Pollex/PZLD-Zoutwachter/hardware/Pinout v0.3.png

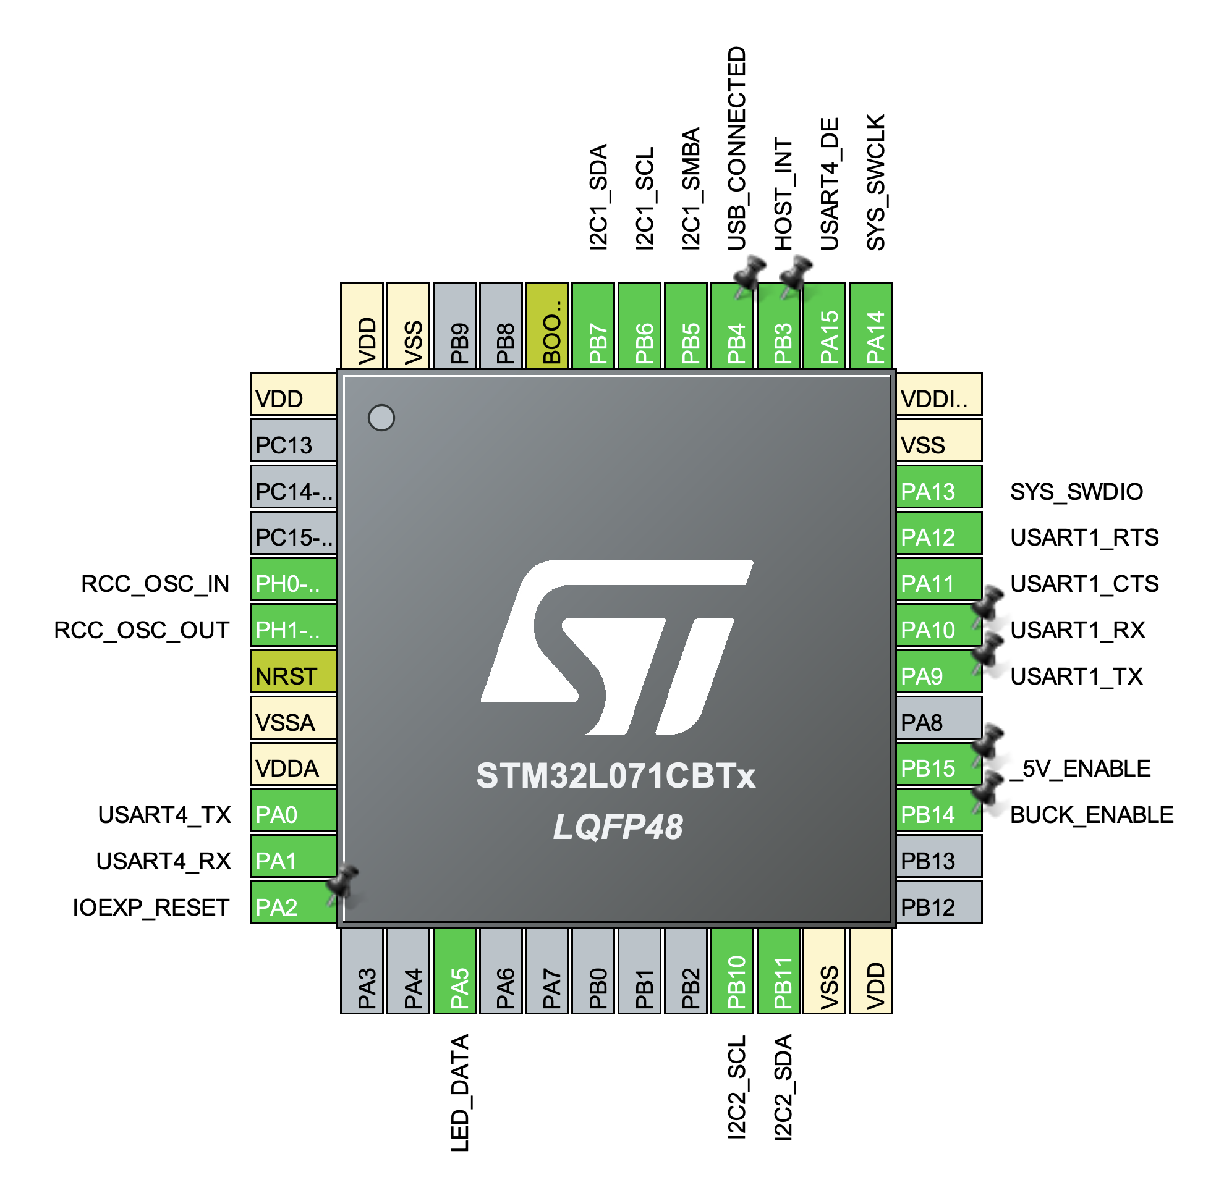
hardware/Pinout v0.3.png
