Pollex/PZLD-Zoutwachter/hardware/MCU.kicad_sch

## KiCad design hardware/MCU.kicad_sch (2025-06-18)

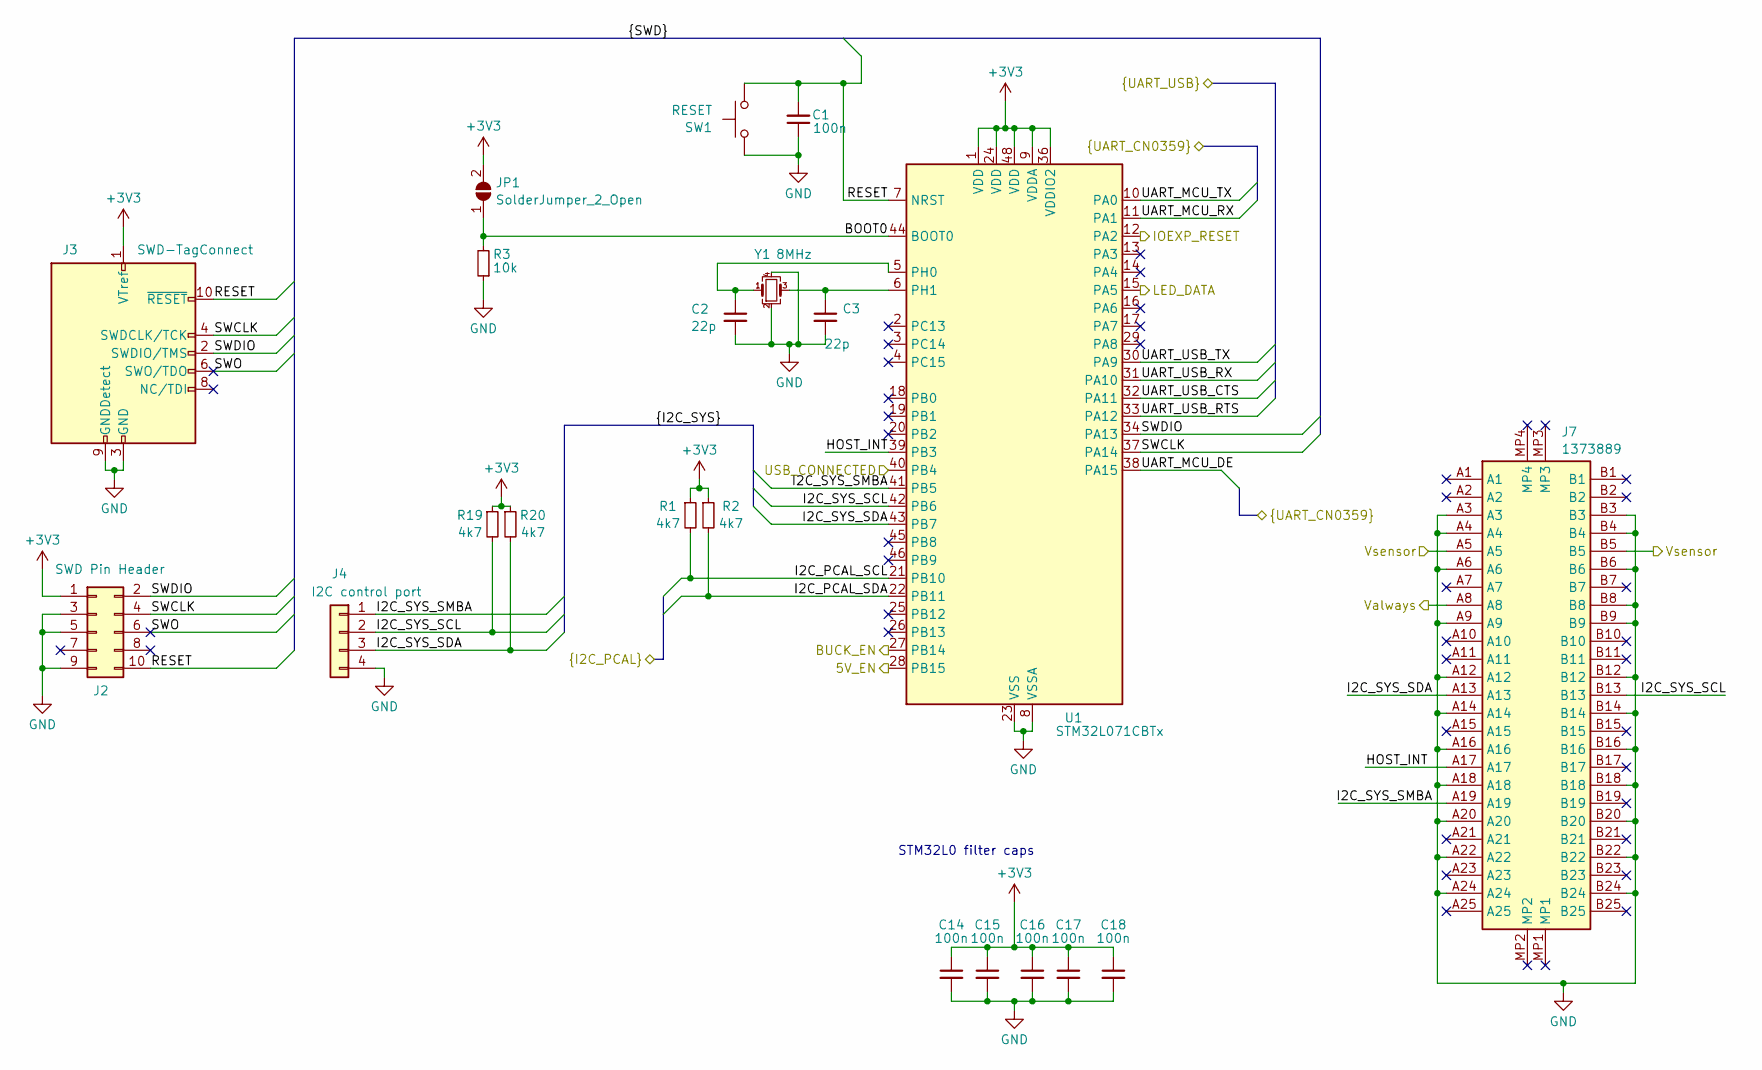
[picture p3: schematic MCU.kicad_sch]

Parts:
C1, C14, C15, C16, C17, C18: 100n; C_0603_1608Metric; LCSC MFR YAGEO
C2, C3: 22p; C_0603_1608Metric; LCSC MFR Samsung Electro-Mechanics
J2: SWD Pin Header; PinHeader_2x05_P1.27mm_Vertical_SMD; LCSC MFR Shenzhen Kinghelm Elec
J3: SWD-TagConnect; Tag-Connect_TC2050-IDC-NL_2x05_P1.27mm_Vertical_with_bottom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
J4: I2C control port; DEALON DW254S-22-04-85 SMD 2x2pin 2.54mm straight; LCSC MFR DEALON
J7: 1373889; Manufacturer_Part_Number 1373889; LCSC MFR Phoenix Contact
JP1: SolderJumper_2_Open; SolderJumper-2_P1.3mm_Open_RoundedPad1.0x1.5mm
R1, R2, R19, R20: 4k7; R_0603_1608Metric; LCSC MFR UNI-ROYAL(Uniroyal Elec)
R3: 10k; R_0603_1608Metric; LCSC MFR UNI-ROYAL(Uniroyal Elec)
SW1: RESET; SW_Push_1P1T_XKB_TS-1187A; LCSC MFR XKB Connectivity
U1: STM32L071CBTx; LQFP-48_7x7mm_P0.5mm; LCSC MFR STMicroelectronics
Y1: 8MHz; Crystal_SMD_3225-4Pin_3.2x2.5mm; LCSC MFR ECS INTERNATIONAL INC

Connections:
5V_EN: U1.28 (PB15)
+3V3: C14.1, C15.1, C16.1, C17.1, C18.1, J2.1, J3.1 (VTref), JP1.2 (B), R1.1, R2.1, R19.1, R20.1, U1.1 (VDD), U1.9 (VDDA), U1.24 (VDD), U1.36 (VDDIO2), U1.48 (VDD)
BOOT0: JP1.1 (A), R3.2, U1.44 (BOOT0)
BUCK_EN: U1.27 (PB14)
GND: C1.1, C2.2, C3.2, C14.2, C15.2, C16.2, C17.2, C18.2, J2.3, J2.5, J2.9, J3.3 (GND), J3.5 (GND), J3.9 (GNDDetect), J4.4, J7.A3, J7.A4, J7.A6, J7.A9, J7.A12, J7.A14, J7.A16, J7.A18, J7.A20, J7.A22, J7.A24, J7.B3, J7.B4, J7.B6, J7.B8, J7.B9, J7.B12, J7.B14, J7.B16, J7.B18, J7.B20, J7.B22, J7.B24, R3.1, SW1.1, U1.8 (VSSA), U1.23 (VSS), U1.35 (VSS), U1.47 (VSS), Y1.2, Y1.4
HOST_INT: J7.A17, U1.39 (PB3)
I2C_PCAL_SCL: R1.2, U1.21 (PB10)
I2C_PCAL_SDA: R2.2, U1.22 (PB11)
I2C_SYS_SCL: J4.2, J7.B13, R19.2, U1.42 (PB6)
I2C_SYS_SDA: J4.3, J7.A13, R20.2, U1.43 (PB7)
I2C_SYS_SMBA: J4.1, J7.A19, U1.41 (PB5)
IOEXP_RESET: U1.12 (PA2)
LED_DATA: U1.15 (PA5)
unnamed: C2.1, U1.5 (PH0), Y1.1
unnamed: C3.1, U1.6 (PH1), Y1.3
RESET: C1.2, J2.10, J3.10 (~RESET), SW1.2, U1.7 (NRST)
SWCLK: J2.4, J3.4 (SWDCLK/TCK), U1.37 (PA14)
SWDIO: J2.2, J3.2 (SWDIO/TMS), U1.34 (PA13)
SWO: J2.6, J3.6 (SWO/TDO)
UART_MCU_DE: U1.38 (PA15)
UART_MCU_RX: U1.11 (PA1)
UART_MCU_TX: U1.10 (PA0)
UART_USB_CTS: U1.32 (PA11)
UART_USB_RTS: U1.33 (PA12)
UART_USB_RX: U1.31 (PA10)
UART_USB_TX: U1.30 (PA9)
USB_CONNECTED: U1.40 (PB4)
Valways: J7.A8
Vsensor: J7.A5, J7.B5

Notes on the sheet:
STM32L0 filter caps
