Pollex/PZLD-Zoutwachter/hardware/Mechanical.kicad_sch

## KiCad design hardware/Mechanical.kicad_sch (2025-06-18)

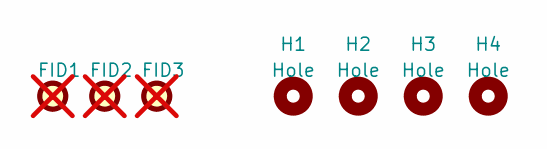
[picture p4: schematic Mechanical.kicad_sch]

Parts:
FID1, FID2, FID3: Fiducial; Fiducial_1mm_Mask2mm; not fitted
H1, H2, H3, H4: Hole; MountingHole_3.2mm_M3
