Pollex/PZLD-Zoutwachter/hardware/Power.kicad_sch

## KiCad design hardware/Power.kicad_sch (2025-06-18)

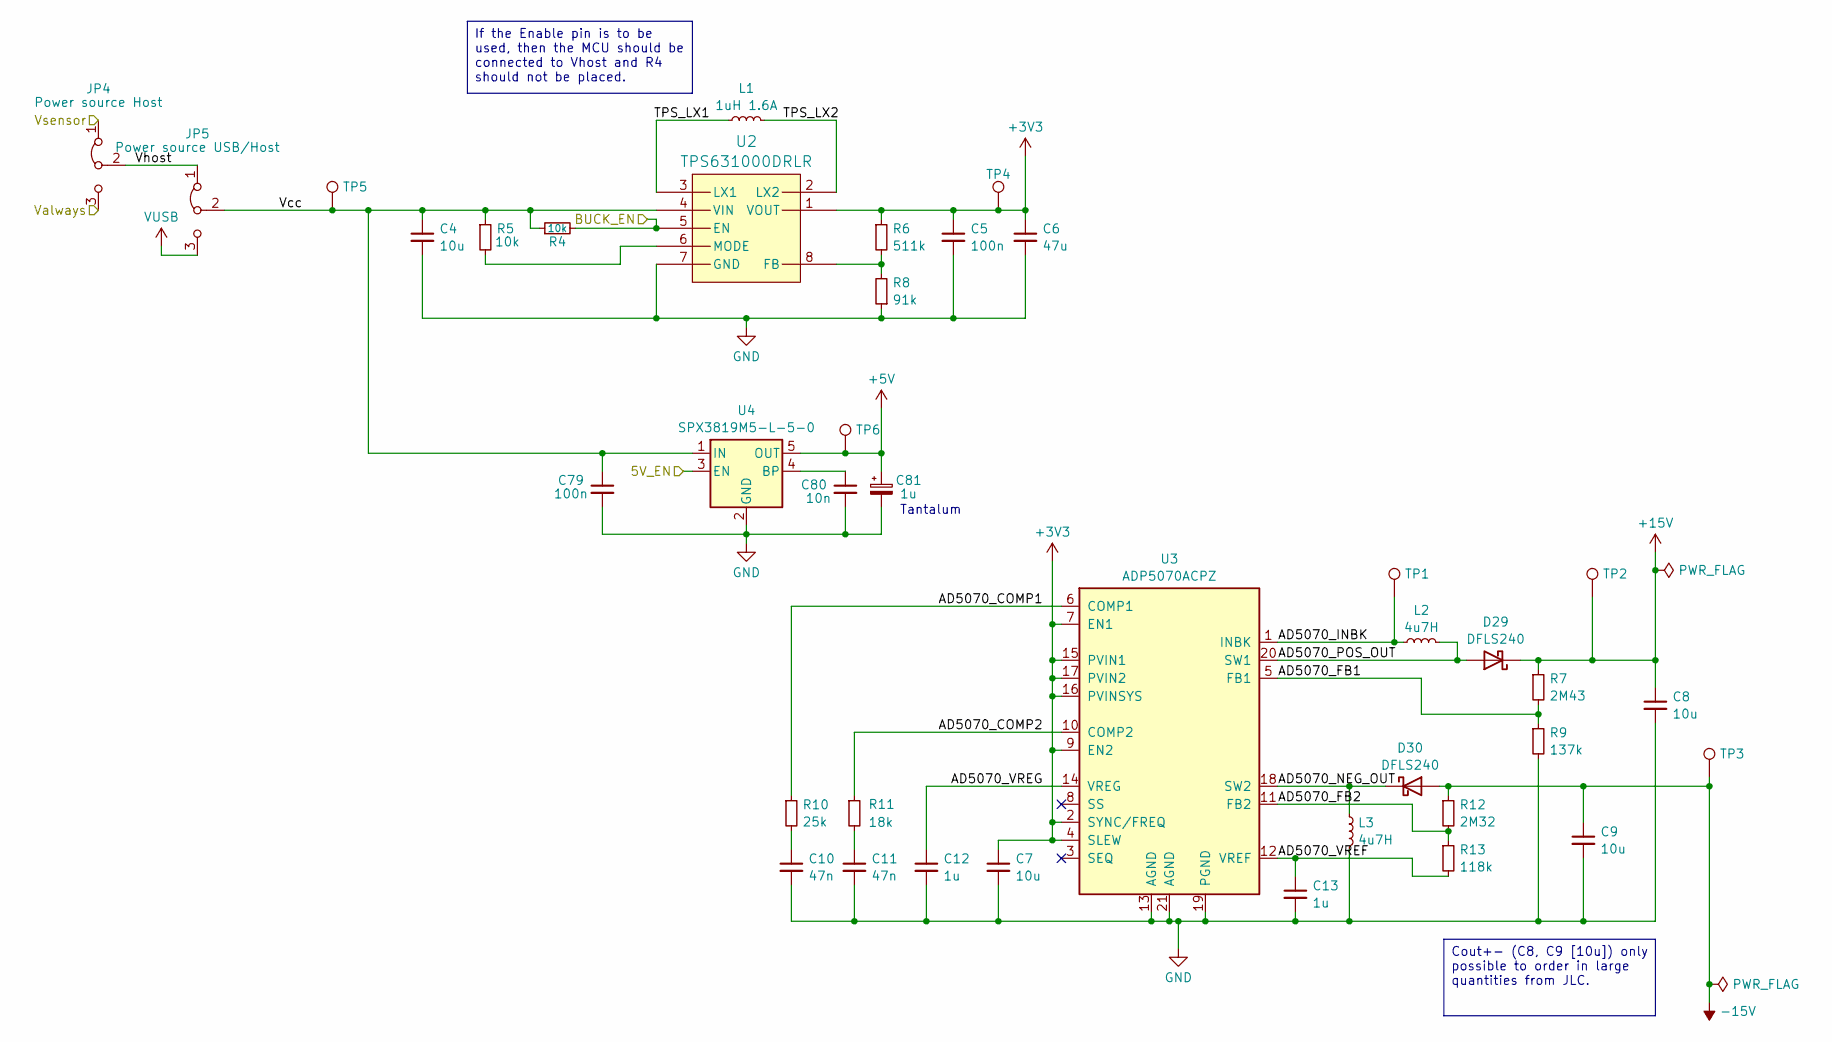
[picture p5: schematic Power.kicad_sch]

Parts:
C4, C7: 10u; C_1206_3216Metric; LCSC MFR Taiyo Yuden
C5, C79: 100n; C_0603_1608Metric; LCSC MFR YAGEO
C6: 47u; C_0603_1608Metric; LCSC MFR Samsung Electro-Mechanics
C8, C9: 10u; C_1210_3225Metric; LCSC MFR Murata Electronics
C10, C11: 47n; C_0603_1608Metric; LCSC MFR Murata Electronics
C12, C13: 1u; C_0603_1608Metric; LCSC MFR Murata Electronics
C80: 10n; C_0603_1608Metric; LCSC MFR FH (Guangdong Fenghua Advanced Tech)
C81: 1u; CP-3216-18; LCSC MFR Vishay Intertech
D29, D30: DFLS240; D_PowerDI-123; LCSC MFR Diodes Inc.
JP4: Power source Host; PinHeader_1x03_P2.54mm_Vertical
JP5: Power source USB/Host; PinHeader_1x03_P2.54mm_Vertical
L1: 1uH 1.6A; L_0603_1608Metric; LCSC MFR Murata Electronics
L2, L3: 4u7H; L_Wuerth_MAPI-4030; LCSC MFR WURTH ELEKTRONIK
R4, R5: 10k; R_0603_1608Metric; LCSC MFR UNI-ROYAL(Uniroyal Elec)
R6: 511k; R_0603_1608Metric; LCSC MFR YAGEO
R7: 2M43; R_0805_2012Metric; LCSC MFR YAGEO
R8: 91k; R_0603_1608Metric; LCSC MFR YAGEO
R9: 137k; R_0603_1608Metric; LCSC MFR YAGEO
R10: 25k; R_0603_1608Metric; LCSC MFR Viking Tech
R11: 18k; R_0603_1608Metric; LCSC MFR UNI-ROYAL(Uniroyal Elec)
R12: 2M32; R_0603_1608Metric; LCSC MFR YAGEO
R13: 118k; R_0603_1608Metric; LCSC MFR YAGEO
TP1, TP2, TP3, TP4, TP5, TP6: TestPoint_Pad_D1.5mm
U2: TPS631000DRLR; TPS631000DRLR_TEX; LCSC MFR TEXAS INSTRUMENTS
U3: ADP5070ACPZ; LFCSP-20-1EP_4x4mm_P0.5mm_EP2.6x2.6mm; LCSC Part # C659268
U4: SPX3819M5-L-5-0; SOT-23-5; LCSC MFR MaxLinear

Connections:
5V_EN: U4.3 (EN)
+3V3: C5.1, C6.1, C7.1, R6.1, TP4.1, U2.1 (VOUT), U3.2 (SYNC/FREQ), U3.4 (SLEW), U3.7 (EN1), U3.9 (EN2), U3.15 (PVIN1), U3.16 (PVINSYS), U3.17 (PVIN2)
+5V: C81.1, TP6.1, U4.5 (OUT)
+15V: C8.1, D29.1 (K), R7.1, TP2.1
-15V: C9.1, D30.2 (A), R12.1, TP3.1
AD5070_COMP1: R10.1, U3.6 (COMP1)
AD5070_COMP2: R11.1, U3.10 (COMP2)
AD5070_FB1: R7.2, R9.1, U3.5 (FB1)
AD5070_FB2: R12.2, R13.1, U3.11 (FB2)
AD5070_INBK: L2.1, TP1.1, U3.1 (INBK)
AD5070_NEG_OUT: D30.1 (K), L3.1, U3.18 (SW2)
AD5070_POS_OUT: D29.2 (A), L2.2, U3.20 (SW1)
AD5070_VREF: C13.1, R13.2, U3.12 (VREF)
AD5070_VREG: C12.1, U3.14 (VREG)
BUCK_EN: R4.2, U2.5 (EN)
GND: C4.2, C5.2, C6.2, C7.2, C8.2, C9.2, C10.2, C11.2, C12.2, C13.2, C79.2, C80.2, C81.2, L3.2, R8.1, R9.2, U2.7 (GND), U3.13 (AGND), U3.19 (PGND), U3.21 (AGND), U4.2 (GND)
unnamed: C10.1, R10.2
unnamed: C11.1, R11.2
unnamed: C80.1, U4.4 (BP)
unnamed: R5.2, U2.6 (MODE)
unnamed: R6.2, R8.2, U2.8 (FB)
TPS_LX1: L1.1, U2.3 (LX1)
TPS_LX2: L1.2, U2.2 (LX2)
VUSB: JP5.3 (B)
Valways: JP4.3 (B)
Vcc: C4.1, C79.1, JP5.2 (C), R4.1, R5.1, TP5.1, U2.4 (VIN), U4.1 (IN)
Vhost: JP4.2 (C), JP5.1 (A)
Vsensor: JP4.1 (A)

Notes on the sheet:
Tantalum
Cout+- (C8, C9 [10u]) only possible to order in large quantities from JLC.
If the Enable pin is to be used, then the MCU should be connected to Vhost and R4 should not be placed.
