Pollex/PZLD-Zoutwachter/hardware/RS485.kicad_sch

## KiCad design hardware/RS485.kicad_sch (2025-06-18)

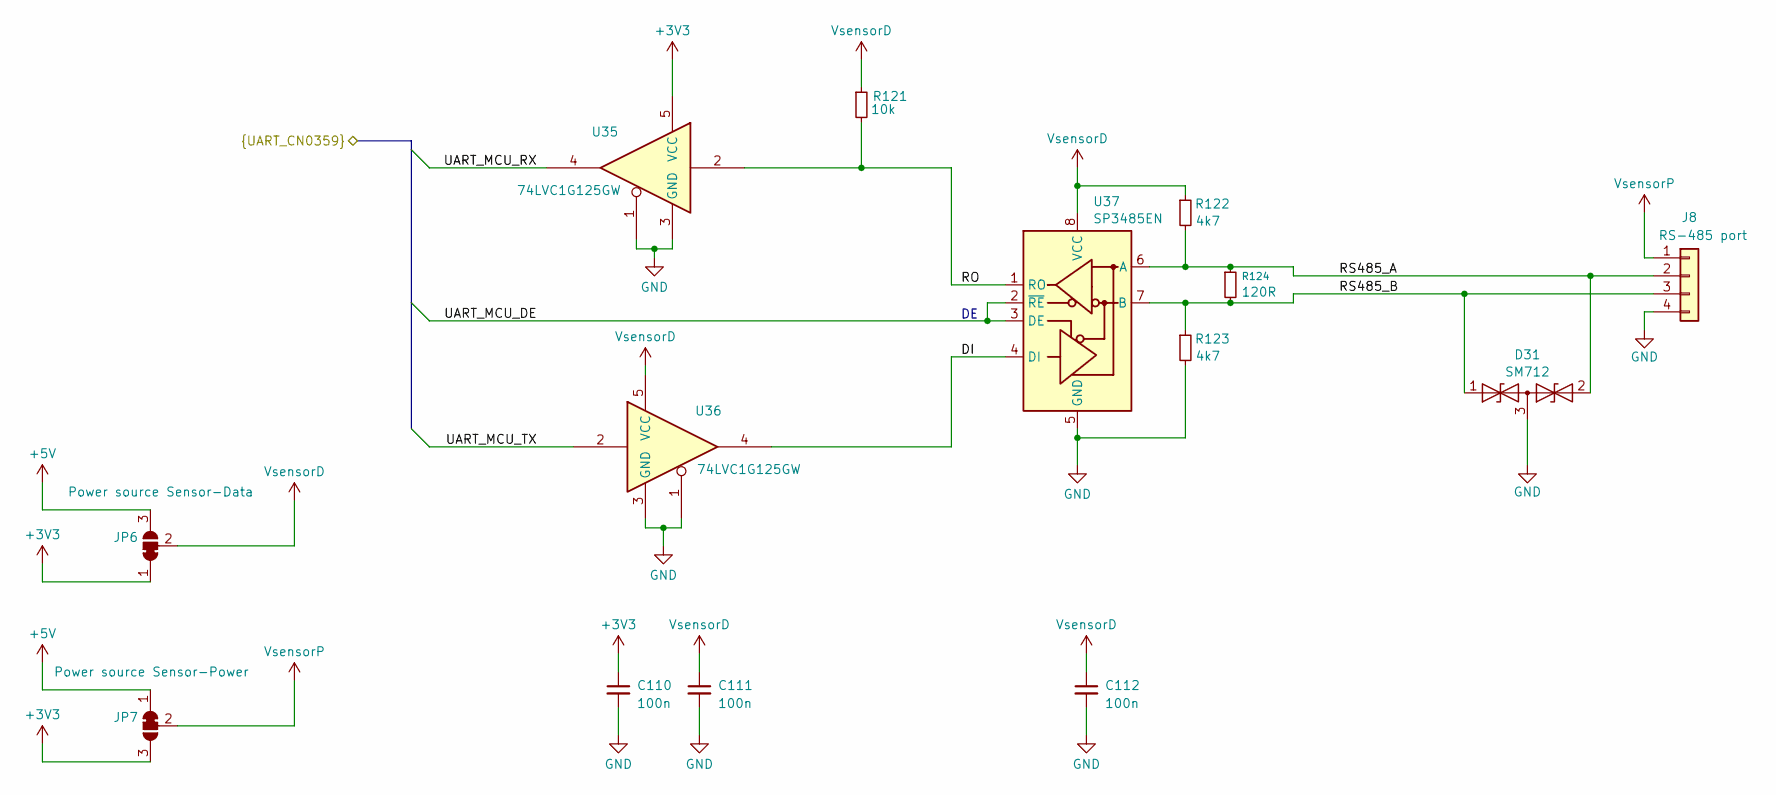
[picture p6: schematic RS485.kicad_sch]

Parts:
C110, C111, C112: 100n; C_0603_1608Metric; LCSC MFR YAGEO
D31: SM712; SOT-23; LCSC MFR SEMTECH
J8: RS-485 port; DEALON DW254S-22-04-85 SMD 2x2pin 2.54mm straight; LCSC MFR DEALON
JP6: Power source Sensor-Data; SolderJumper-3_P1.3mm_Bridged12_RoundedPad1.0x1.5mm
JP7: Power source Sensor-Power; SolderJumper-3_P1.3mm_Bridged12_RoundedPad1.0x1.5mm
R121: 10k; R_0603_1608Metric; LCSC MFR UNI-ROYAL(Uniroyal Elec)
R122, R123: 4k7; R_0603_1608Metric; LCSC MFR UNI-ROYAL(Uniroyal Elec)
R124: 120R; R_0603_1608Metric; LCSC MFR UNI-ROYAL(Uniroyal Elec)
U35, U36: 74LVC1G125GW; SOT-353_SC-70-5; LCSC MFR Nexperia
U37: SP3485EN; SOIC-8_3.9x4.9mm_P1.27mm; LCSC MFR MaxLinear

Connections:
+3V3: C110.1, JP6.1 (A), JP7.3 (B), U35.5 (VCC)
+5V: JP6.3 (B), JP7.1 (A)
DI: U36.4, U37.4 (DI)
GND: C110.2, C111.2, C112.2, D31.3 (common), J8.4, R123.2, U35.1, U35.3 (GND), U36.1, U36.3 (GND), U37.5 (GND)
RO: R121.2, U35.2, U37.1 (RO)
RS485_A: D31.2 (A2), J8.2, R122.2, R124.1, U37.6 (A)
RS485_B: D31.1 (A1), J8.3, R123.1, R124.2, U37.7 (B)
UART_MCU_DE: U37.2 (~RE), U37.3 (DE)
UART_MCU_RX: U35.4
UART_MCU_TX: U36.2
VsensorD: C111.1, C112.1, JP6.2 (C), R121.1, R122.1, U36.5 (VCC), U37.8 (VCC)
VsensorP: J8.1, JP7.2 (C)
