Pollex/PZLD-Zoutwachter/hardware/Switch.kicad_sch

## KiCad design hardware/Switch.kicad_sch (2025-06-18)

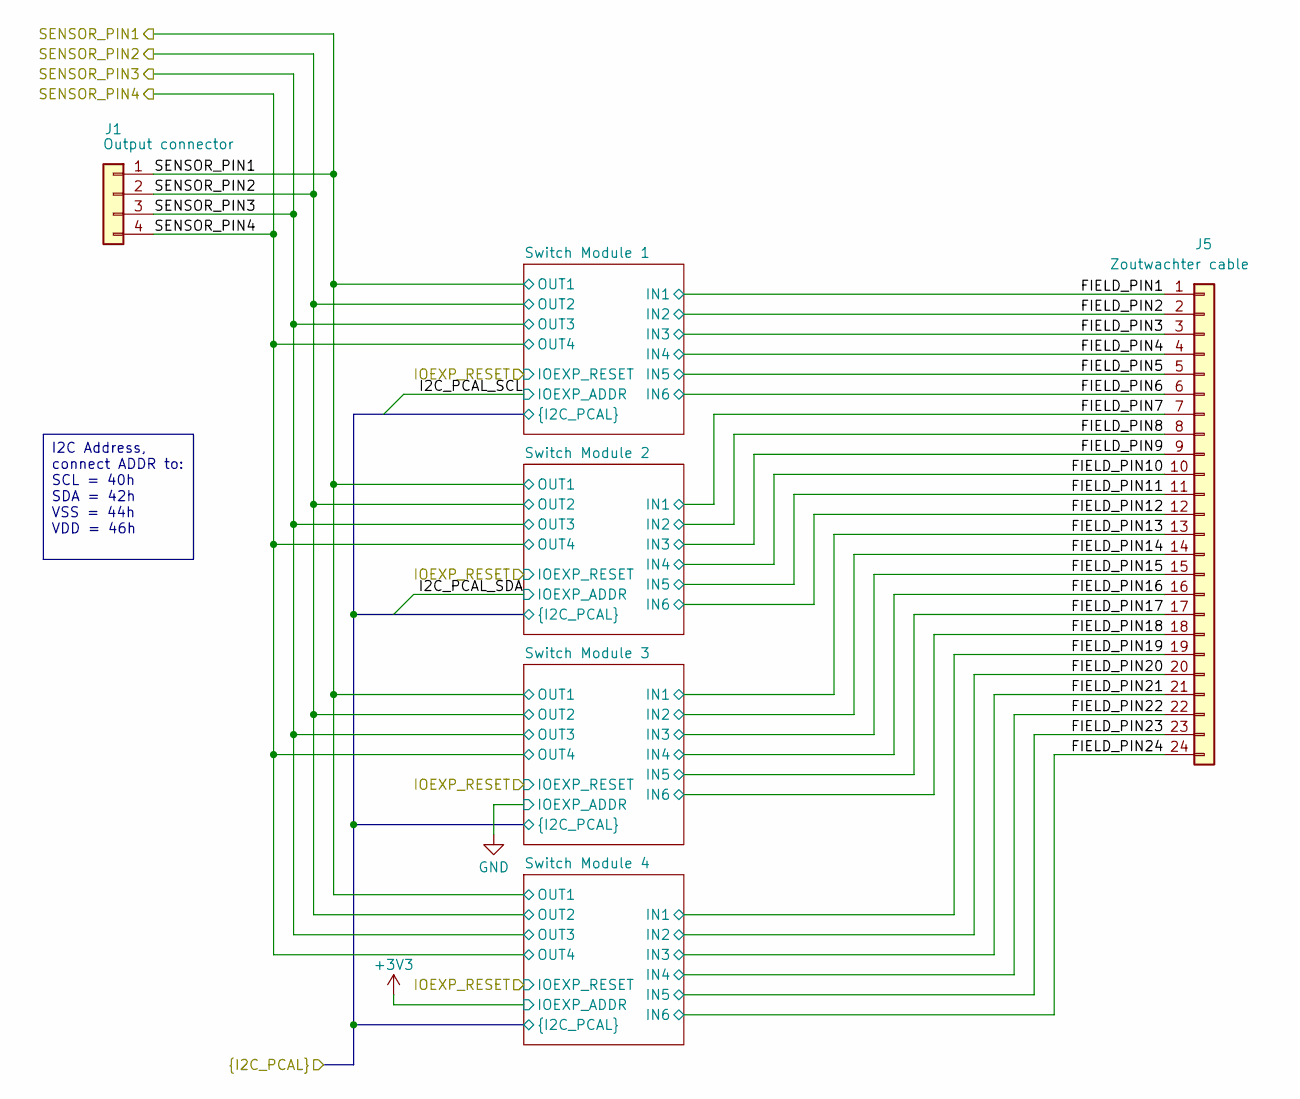
[picture p7: schematic Switch.kicad_sch]

Parts:
J1: Output connector; 1755752
J5: Zoutwachter cable; 1755956

Connections:
FIELD_PIN1: J5.1
FIELD_PIN2: J5.2
FIELD_PIN3: J5.3
FIELD_PIN4: J5.4
FIELD_PIN5: J5.5
FIELD_PIN6: J5.6
FIELD_PIN7: J5.7
FIELD_PIN8: J5.8
FIELD_PIN9: J5.9
FIELD_PIN10: J5.10
FIELD_PIN11: J5.11
FIELD_PIN12: J5.12
FIELD_PIN13: J5.13
FIELD_PIN14: J5.14
FIELD_PIN15: J5.15
FIELD_PIN16: J5.16
FIELD_PIN17: J5.17
FIELD_PIN18: J5.18
FIELD_PIN19: J5.19
FIELD_PIN20: J5.20
FIELD_PIN21: J5.21
FIELD_PIN22: J5.22
FIELD_PIN23: J5.23
FIELD_PIN24: J5.24
SENSOR_PIN1: J1.1
SENSOR_PIN2: J1.2
SENSOR_PIN3: J1.3
SENSOR_PIN4: J1.4

Notes on the sheet:
I2C Address, connect ADDR to:  SCL = 40h SDA = 42h VSS = 44h VDD = 46h
