Pollex/PZLD-Zoutwachter/hardware/Switch_ADG.kicad_sch

## KiCad design hardware/Switch_ADG.kicad_sch (2025-06-18)

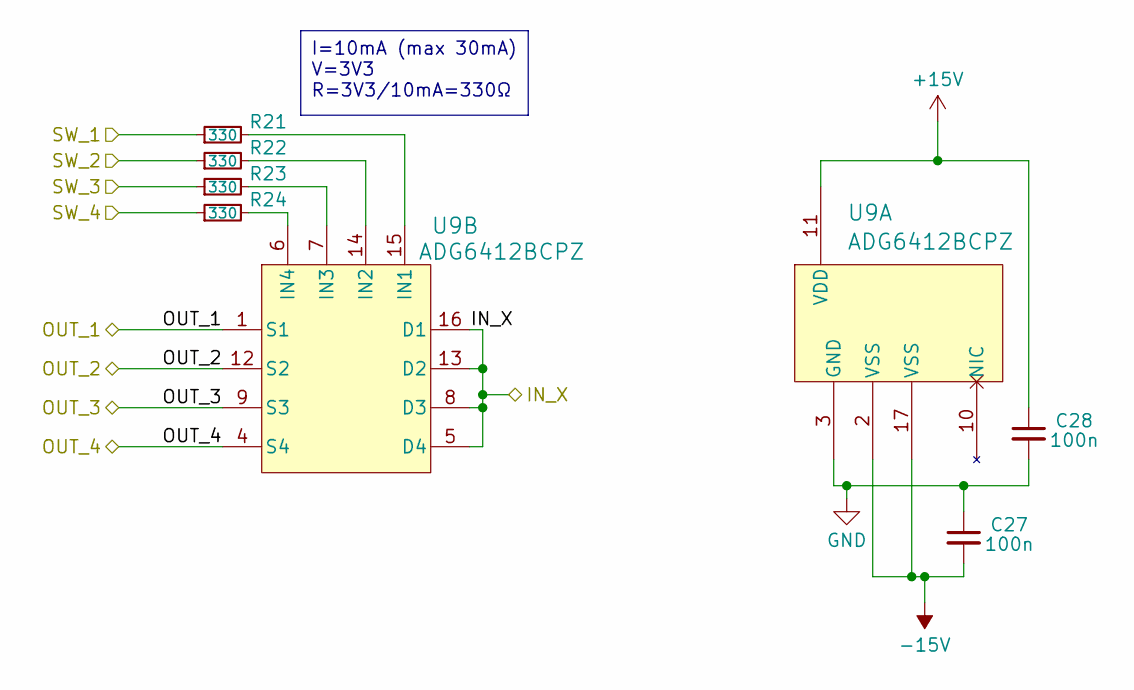
[picture p8: schematic Switch_ADG.kicad_sch]

Parts:
C27, C28: 100n; C_0603_1608Metric; LCSC MFR YAGEO
R21, R22, R23, R24: 330; R_0603_1608Metric; LCSC MFR UNI-ROYAL(Uniroyal Elec)
U9: ADG6412BCPZ; LCSC Part # C5555803

Connections:
+15V: C28.1, U9.11 (VDD)
-15V: C27.2, U9.2 (VSS), U9.17 (VSS)
GND: C27.1, C28.2, U9.3 (GND)
IN_X: U9.5 (D4), U9.8 (D3), U9.13 (D2), U9.16 (D1)
unnamed: R21.2, U9.15 (IN1)
unnamed: R22.2, U9.14 (IN2)
unnamed: R23.2, U9.7 (IN3)
unnamed: R24.2, U9.6 (IN4)
OUT_1: U9.1 (S1)
OUT_2: U9.12 (S2)
OUT_3: U9.9 (S3)
OUT_4: U9.4 (S4)
SW_1: R21.1
SW_2: R22.1
SW_3: R23.1
SW_4: R24.1

Notes on the sheet:
I=10mA (max 30mA) V=3V3 R=3V3/10mA=330Ω
