Pollex/PZLD-Zoutwachter/hardware/Switch_Module.kicad_sch

## KiCad design hardware/Switch_Module.kicad_sch (2025-06-18)

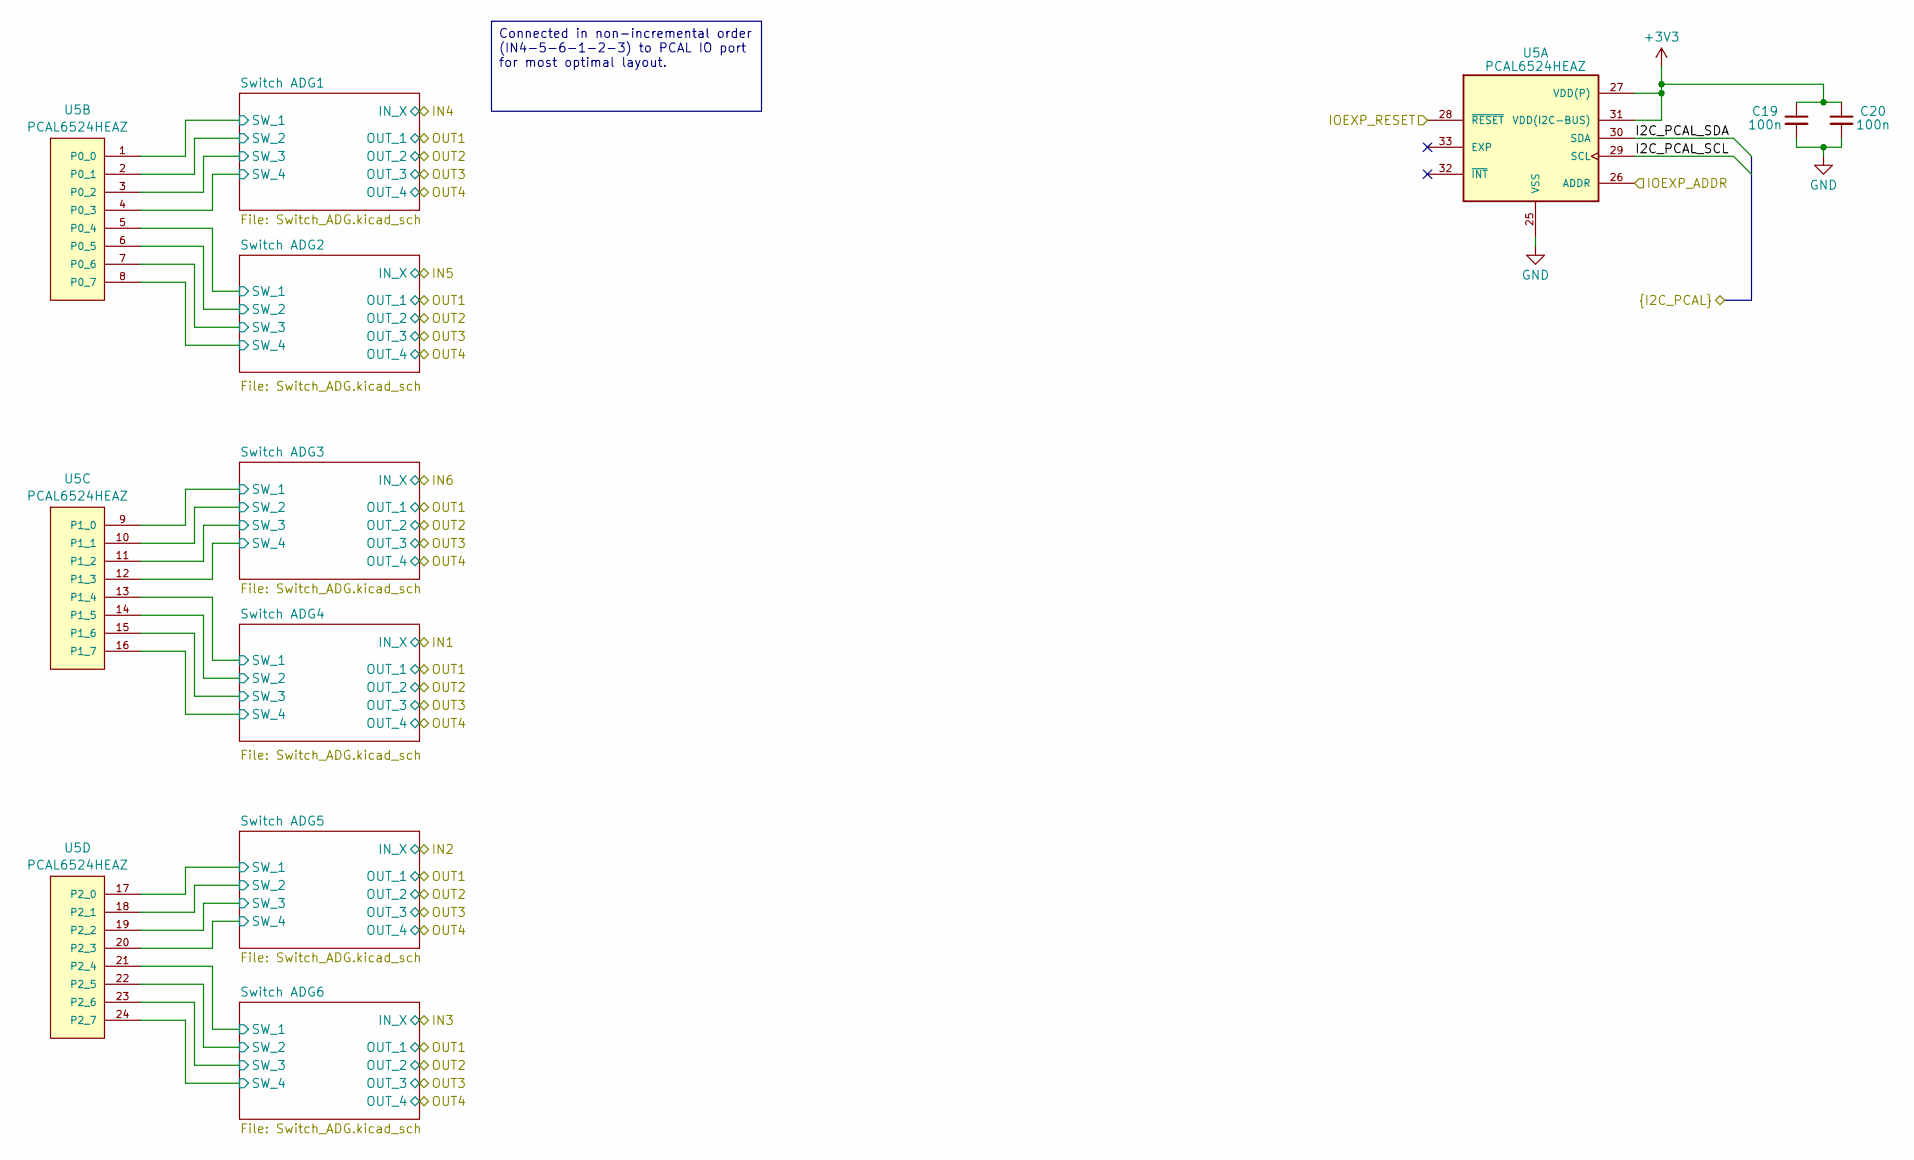
[picture p9: schematic Switch_Module.kicad_sch]

Parts:
C19, C20: 100n; C_0603_1608Metric; LCSC MFR YAGEO
U5: PCAL6524HEAZ; LCSC Part # C3000497

Connections:
+3V3: C19.1, C20.1, U5.27 (VDD(P)), U5.31 (VDD(I2C-BUS))
GND: C19.2, C20.2, U5.25 (VSS)
I2C_PCAL_SCL: U5.29 (SCL)
I2C_PCAL_SDA: U5.30 (SDA)
IOEXP_ADDR: U5.26 (ADDR)
IOEXP_RESET: U5.28 (~RESET)
SW_1: U5.1 (P0_0), U5.5 (P0_4), U5.9 (P1_0), U5.13 (P1_4), U5.17 (P2_0), U5.21 (P2_4)
SW_2: U5.2 (P0_1), U5.6 (P0_5), U5.10 (P1_1), U5.14 (P1_5), U5.18 (P2_1), U5.22 (P2_5)
SW_3: U5.3 (P0_2), U5.7 (P0_6), U5.11 (P1_2), U5.15 (P1_6), U5.19 (P2_2), U5.23 (P2_6)
SW_4: U5.4 (P0_3), U5.8 (P0_7), U5.12 (P1_3), U5.16 (P1_7), U5.20 (P2_3), U5.24 (P2_7)

Notes on the sheet:
Connected in non-incremental order (IN4-5-6-1-2-3) to PCAL IO port for most optimal layout.
