Pollex/PZLD-Zoutwachter/hardware/USB.kicad_sch

## KiCad design hardware/USB.kicad_sch (2025-06-18)

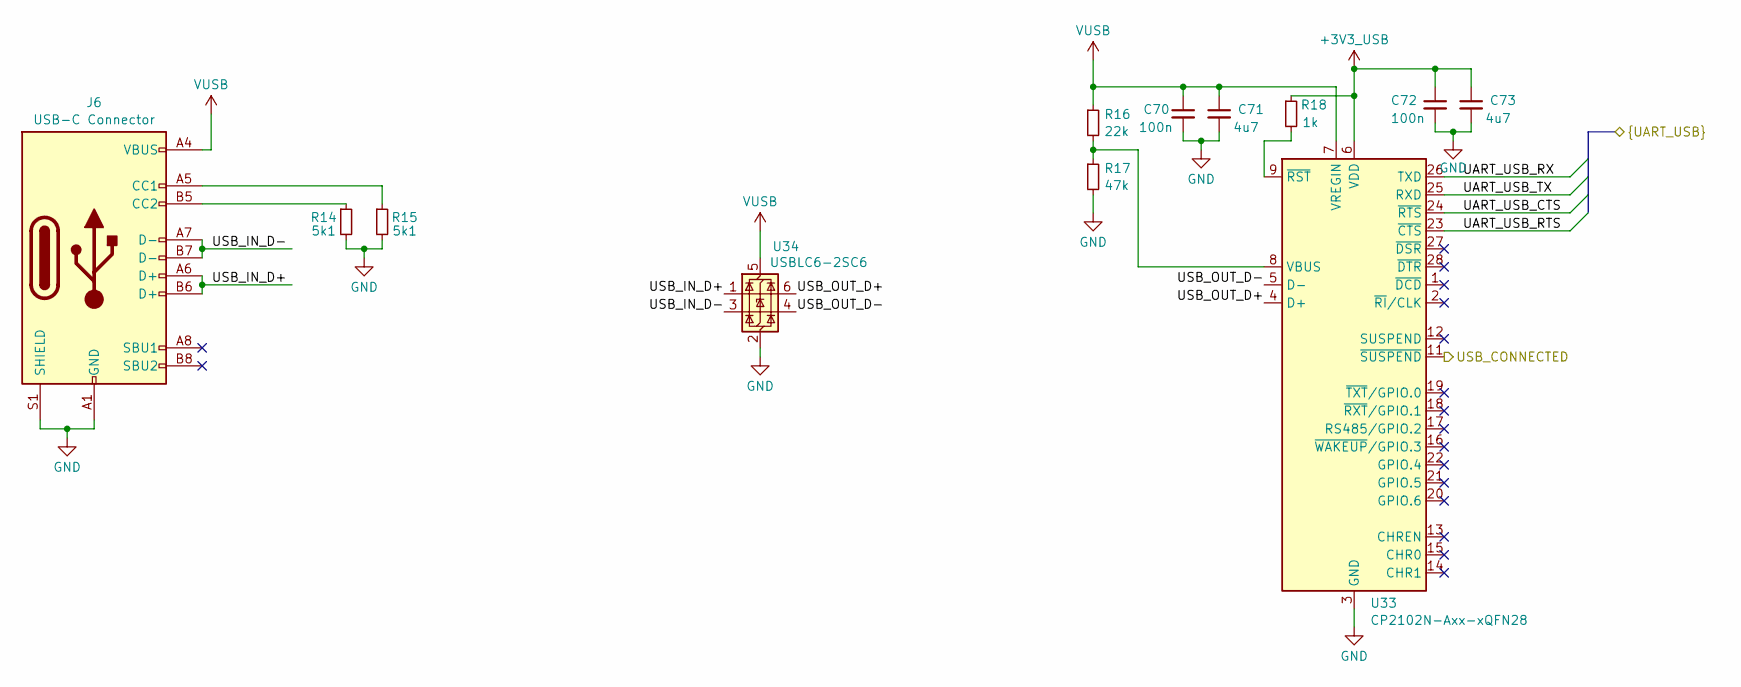
[picture p10: schematic USB.kicad_sch]

Parts:
C70, C72: 100n; C_0603_1608Metric; LCSC MFR YAGEO
C71, C73: 4u7; C_0603_1608Metric; LCSC MFR Samsung Electro-Mechanics
J6: USB-C Connector; MOLEX_2171820001; LCSC MFR MOLEX
R14, R15: 5k1; R_0603_1608Metric; LCSC MFR UNI-ROYAL(Uniroyal Elec)
R16: 22k; R_0603_1608Metric; LCSC MFR UNI-ROYAL(Uniroyal Elec)
R17: 47k; R_0603_1608Metric; LCSC MFR UNI-ROYAL(Uniroyal Elec)
R18: 1k; R_0603_1608Metric; LCSC MFR UNI-ROYAL(Uniroyal Elec)
U33: CP2102N-Axx-xQFN28; QFN-28-1EP_5x5mm_P0.5mm_EP3.35x3.35mm; LCSC MFR SILICON LABS
U34: USBLC6-2SC6; SOT-23-6; LCSC MFR STMicroelectronics

Connections:
+3V3_USB: C72.1, C73.1, R18.1, U33.6 (VDD)
GND: C70.2, C71.2, C72.2, C73.2, J6.A1 (GND), J6.A12 (GND), J6.B1 (GND), J6.B12 (GND), J6.S1 (SHIELD), R14.2, R15.2, R17.2, U33.3 (GND), U33.29 (GND), U34.2 (GND)
unnamed: J6.A5 (CC1), R15.1
unnamed: J6.B5 (CC2), R14.1
unnamed: R16.2, R17.1, U33.8 (VBUS)
unnamed: R18.2, U33.9 (~RST)
UART_USB_CTS: U33.24 (~RTS)
UART_USB_RTS: U33.23 (~CTS)
UART_USB_RX: U33.26 (TXD)
UART_USB_TX: U33.25 (RXD)
USB_CONNECTED: U33.11 (~SUSPEND)
USB_IN_D+: J6.A6 (D+), J6.B6 (D+), U34.1 (I/O1)
USB_IN_D-: J6.A7 (D-), J6.B7 (D-), U34.3 (I/O2)
USB_OUT_D+: U33.4 (D+), U34.6 (I/O1)
USB_OUT_D-: U33.5 (D-), U34.4 (I/O2)
VUSB: C70.1, C71.1, J6.A4 (VBUS), J6.A9 (VBUS), J6.B4 (VBUS), J6.B9 (VBUS), R16.1, U33.7 (VREGIN), U34.5 (VBUS)
