Pollex/PZLD-Zoutwachter/(commit log)

2024-03-29 Update board.h for newest proto
2024-03-29 feat(RGB): WS2812B driver
    [LED.kicad_sch, Power.kicad_sch, Switch.kicad_sch, Switch_ADG.kicad_sch, USB.kicad_sch, Zoutwachter-switch.kicad_pcb, Zoutwachter-switch.kicad_sch]
2024-04-03 fix(ws281x): off by 1 and desync
    [main.c, stws281x.c]
2024-04-10 Fix pcal bug wrong pin set
    [main.c, pcal6524.c]
2024-04-12 Add elektrode switch and CSV write
2024-04-15 feat(sbc): add stabilization time after switch
2024-04-15 fix(switch): update all elektrodes at once
    [main.c]
2025-06-18 diagram add kelvin circuit-ish
2025-06-18 commit pending hw changes (rather old by now...)
    [LED.kicad_sch, Power.kicad_sch, Switch.kicad_sch, Switch_ADG.kicad_sch, USB.kicad_sch, Zoutwachter-switch.kicad_sch]
2025-06-18 rename switch-firmware folder
2025-06-18 HW: update to latest version
    [LED.kicad_sch, MCU.kicad_sch, Mechanical.kicad_sch, Power.kicad_sch, RS485.kicad_sch, Switch.kicad_sch, Switch_ADG.kicad_sch, Switch_Module.kicad_sch]
